ManiacalLabs/GalvoDriver/README.md

# GalvoDriver
Galvanometer Controller, DAC and Audio In
