ManiacalLabs/GalvoDriver/PCB/GalvoDriver.kicad_pcb

## KiCad design PCB/GalvoDriver.kicad_pcb (2020-10-03)

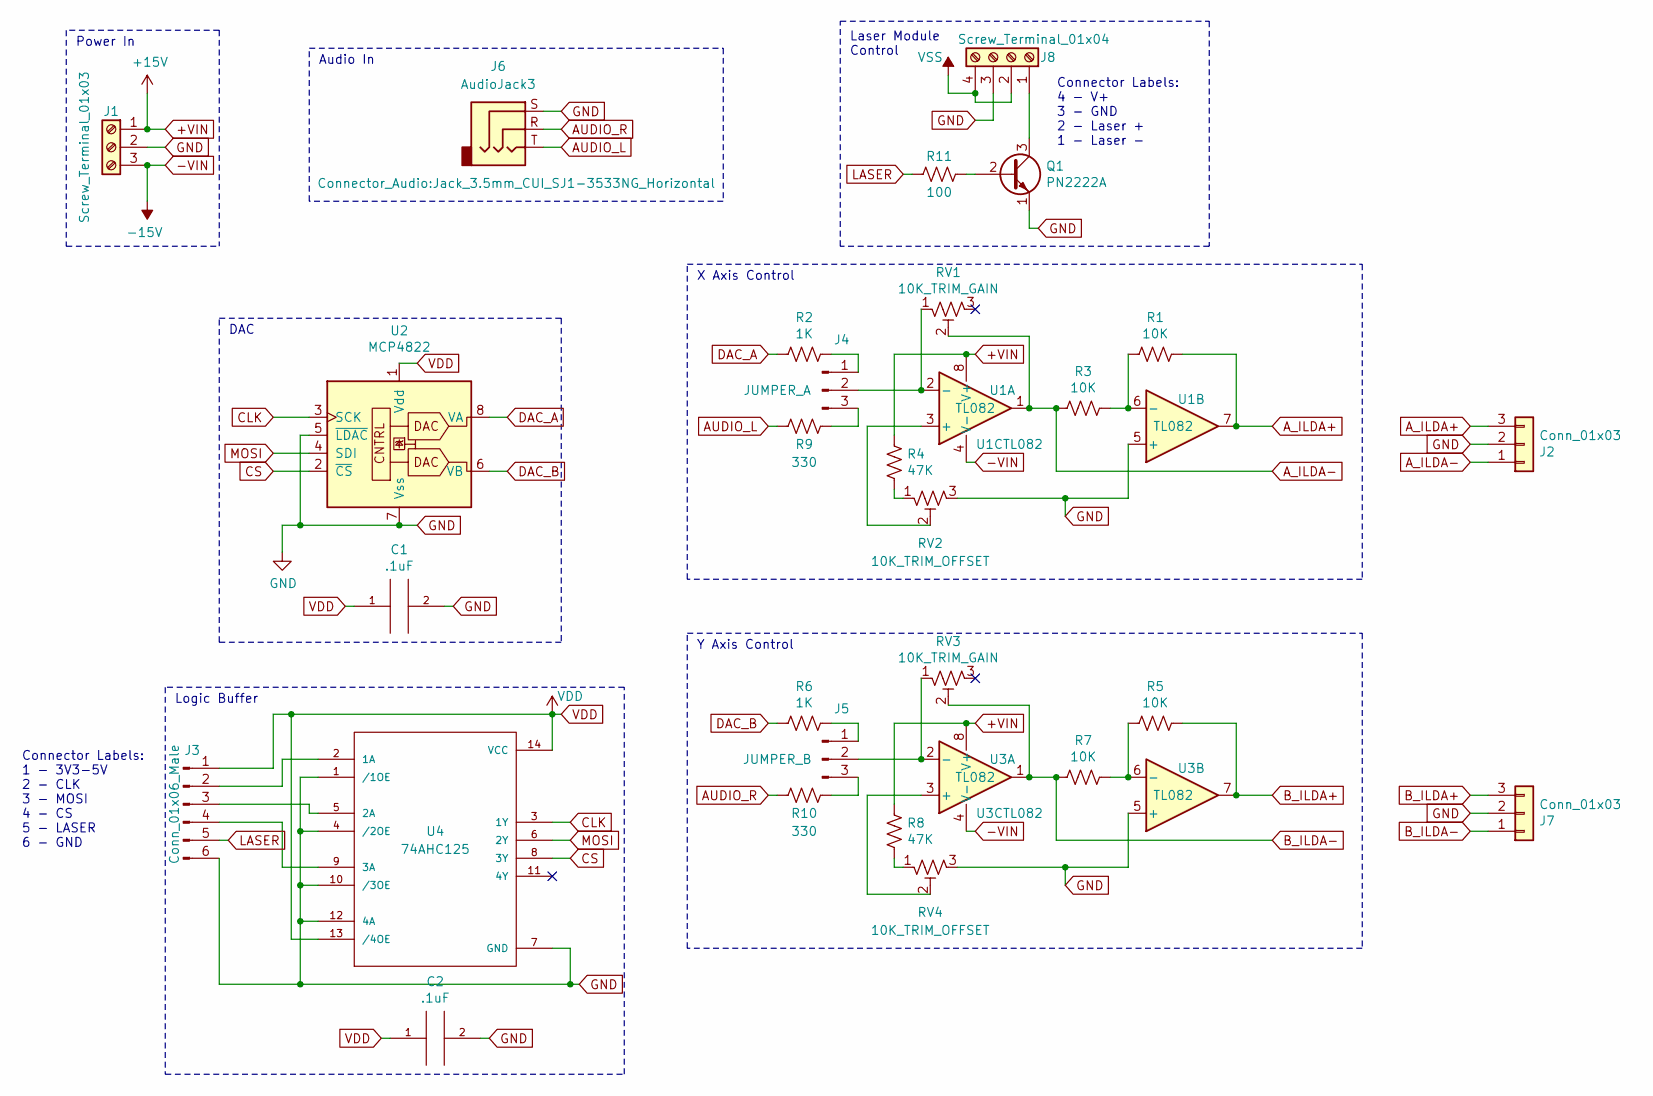
[picture p1: schematic GalvoDriver.sch]

Parts:
C1, C2: .1uF; C_Disc_D5.0mm_W2.5mm_P2.50mm
J1: Screw_Terminal_01x03; TerminalBlock_Phoenix_MKDS1.5-3pol
J2, J7: Conn_01x03; JST_XH_B03B-XH-A_03x2.50mm_Straight
J3: Conn_01x06_Male; Pin_Header_Straight_1x06_Pitch2.54mm
J4: JUMPER_A; Pin_Header_Straight_1x03_Pitch2.54mm
J5: JUMPER_B; Pin_Header_Straight_1x03_Pitch2.54mm
J6: AudioJack3; Jack_3.5mm_CUI_SJ1-3533NG_Horizontal
J8: Screw_Terminal_01x04; TerminalBlock_Phoenix_MKDS1.5-4pol
Q1: PN2222A; TO-92_Inline_Wide
R1, R3, R5, R7: 10K; R_Axial_DIN0207_L6.3mm_D2.5mm_P10.16mm_Horizontal
R2, R6: 1K; R_Axial_DIN0207_L6.3mm_D2.5mm_P10.16mm_Horizontal
R4, R8: 47K; R_Axial_DIN0207_L6.3mm_D2.5mm_P10.16mm_Horizontal
R9, R10: 330; R_Axial_DIN0207_L6.3mm_D2.5mm_P10.16mm_Horizontal
R11: 100; R_Axial_DIN0207_L6.3mm_D2.5mm_P10.16mm_Horizontal
RV1, RV3: 10K_TRIM_GAIN; Potentiometer_Trimmer_Bourns_3296W
RV2, RV4: 10K_TRIM_OFFSET; Potentiometer_Trimmer_Bourns_3296W
U1, U3: TL082; DIP-8_W7.62mm_Socket
U2: MCP4822; DIP-8_W7.62mm_Socket
U4: 74AHC125; DIP-14_W7.62mm_Socket

Connections:
+VIN: J1.1, R4.2, R8.2, U1.8 (V+), U3.8 (V+)
-VIN: J1.3, U1.4 (V-), U3.4 (V-)
AUDIO_L: J6.T, R9.2
AUDIO_R: J6.R, R10.2
A_ILDA+: J2.3, R1.1, U1.7
A_ILDA-: J2.1, R3.2, RV1.2, U1.1
B_ILDA+: J7.3, R5.1, U3.7
B_ILDA-: J7.1, R7.2, RV3.2, U3.1
CLK: U2.3 (SCK), U4.3 (1Y)
CS: U2.2 (~CS), U4.8 (3Y)
DAC_A: R2.2, U2.8 (VA)
DAC_B: R6.2, U2.6 (VB)
GND: C1.2, C2.2, J1.2, J2.2, J3.6, J6.S, J7.2, J8.3, Q1.1 (E), RV2.3, RV4.3, U1.5 (+), U2.5 (~LDAC), U2.7 (Vss), U3.5 (+), U4.1 (/1OE), U4.4 (/2OE), U4.7 (GND), U4.10 (/3OE), U4.12 (4A)
LASER: J3.5, R11.2
MOSI: U2.4 (SDI), U4.6 (2Y)
unnamed: J3.2, U4.2 (1A)
unnamed: J3.3, U4.5 (2A)
unnamed: J3.4, U4.9 (3A)
unnamed: J4.1, R2.1
unnamed: J4.2, RV1.1, U1.2 (-)
unnamed: J4.3, R9.1
unnamed: J5.1, R6.1
unnamed: J5.2, RV3.1, U3.2 (-)
unnamed: J5.3, R10.1
unnamed: J8.1, Q1.3 (C)
unnamed: Q1.2 (B), R11.1
unnamed: R1.2, R3.1, U1.6 (-)
unnamed: R4.1, RV2.1
unnamed: R5.2, R7.1, U3.6 (-)
unnamed: R8.1, RV4.1
unnamed: RV2.2, U1.3 (+)
unnamed: RV4.2, U3.3 (+)
VDD: C1.1, C2.1, J3.1, U2.1 (Vdd), U4.13 (/4OE), U4.14 (VCC)
VSS: J8.2, J8.4

Notes on the sheet:
Connector Labels: 1 - 3V3-5V 2 - CLK 3 - MOSI 4 - CS 5 - LASER 6 - GND
Y Axis Control
X Axis Control
Connector Labels: 4 - V+ 3 - GND 2 - Laser + 1 - Laser -
Laser Module Control
Power In
DAC
Audio In
Logic Buffer

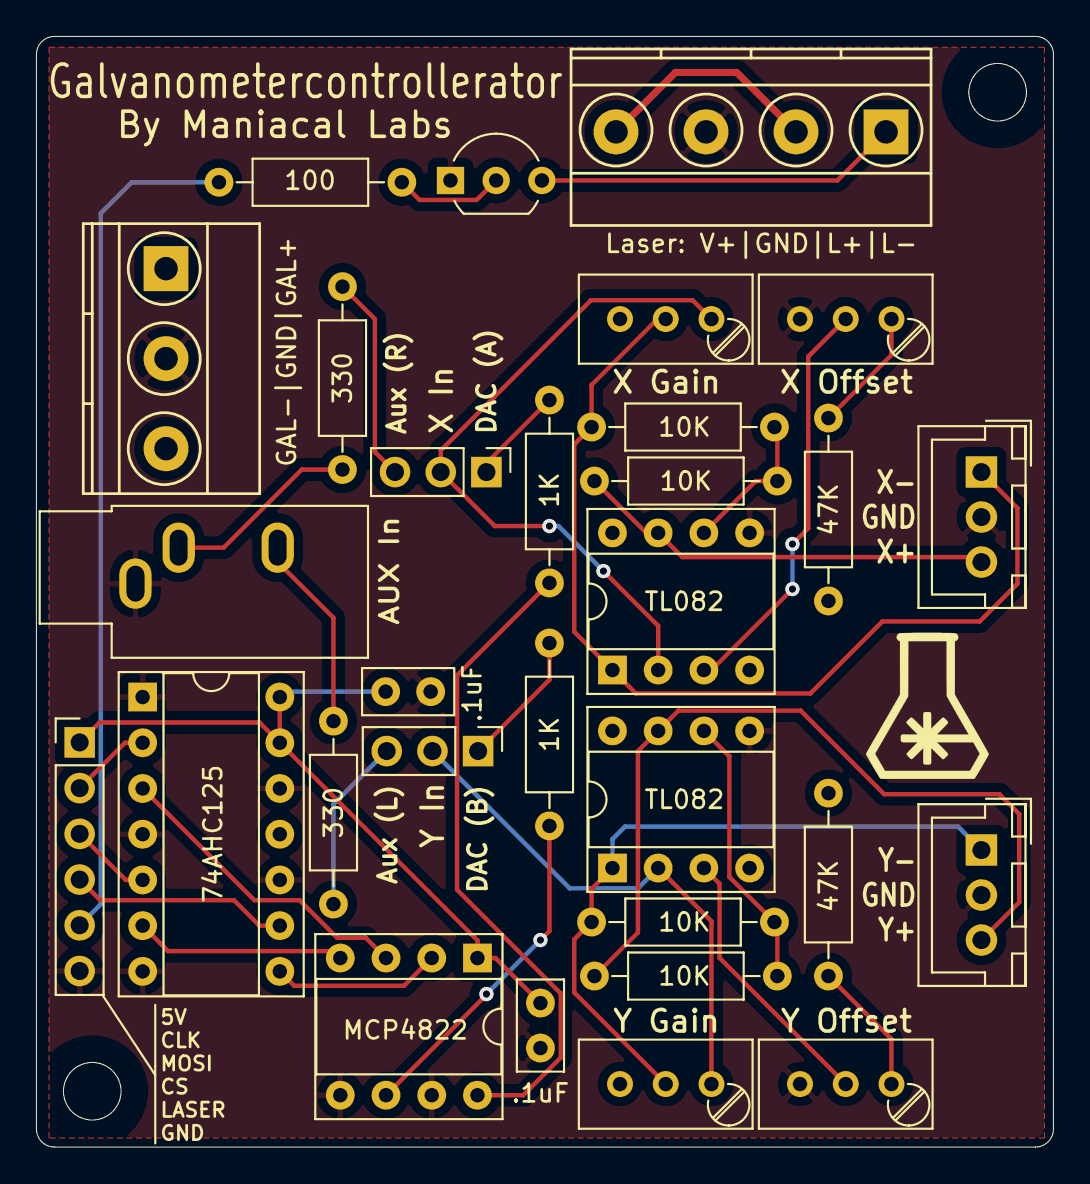
[picture p2: board GalvoDriver.kicad_pcb from above]

Board: 4 copper layers, 56.5 x 61.7 mm, 30 parts (0 on the bottom side), 34 nets.
