ManiacalLabs/GalvoDriver/LaserDemo/p_test.h

const uint32_t PROGMEM draw_test[] = {
0x879b03e5,
0x8795042c,
0x8795042c,
0x87840471,
0x87840471,
0x876804b1,
0x876804b1,
0x874304eb,
0x874304eb,
0x8716051d,
0x8716051d,
0x86e30545,
0x86e30545,
0x86ad0562,
0x86ad0562,
0x86740575,
0x86740575,
0x863c057d,
0x863c057d,
0x8607057a,
0x8607057a,
0x85d7056d,
0x85d7056d,
0x85ad0559,
0x85ad0559,
0x858c053d,
0x858c053d,
0x8574051d,
0x8574051d,
0x856704fa,
0x856704fa,
0x856404d7,
0x856404d7,
0x856b04b6,
0x856b04b6,
0x857b0499,
0x857b0499,
0x85940483,
0x85940483,
0x85b40474,
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
};

void test() {
  objectCount++;  
  objectAddress[objectCount] = draw_test;
  objectName[objectCount] = "test";
  objectSize[objectCount] = sizeof(draw_test)/sizeof(uint32_t);
}
