ManiacalLabs/GalvoDriver/(commit log)

2020-06-28 KiCAD Project commit
    [GalvoDriver.kicad_pcb, GalvoDriver.sch]
2020-06-28 Moved to PCB dir
    [GalvoDriver.kicad_pcb, GalvoDriver.sch]
2020-07-07 Added Laser Module Control + terminal
    [GalvoDriver.kicad_pcb, GalvoDriver.sch]
2020-07-07 Added terminal labels, exported gerbers for fab.
    [GalvoDriver-B_Cu.gbr, GalvoDriver-B_Mask.gbr, GalvoDriver-Edge_Cuts.gbr, GalvoDriver-F_Cu.gbr, GalvoDriver-F_Mask.gbr, GalvoDriver-F_SilkS.gbr, GalvoDriver-In1_Cu.gbr, GalvoDriver-In2_Cu.gbr]
2020-07-14 Changed decoupling cap value to 0.1uF
    [GalvoDriver.kicad_pcb, GalvoDriver.sch]
2020-08-19 Starting work on PCB changes for v1.1
    [GalvoDriver.sch]
2020-08-19 Level shifter, thrm. relief, xistor pad, audio jack move
    [GalvoDriver.kicad_pcb, GalvoDriver.sch]
2020-08-19 Fixing Aux In and C2 silk
    [GalvoDriver.kicad_pcb]
2020-09-03 Generated gerber files, uploaded v2 to board fab.
    [GalvoDriver-B_Cu.gbr, GalvoDriver-B_Mask.gbr, GalvoDriver-Edge_Cuts.gbr, GalvoDriver-F_Cu.gbr, GalvoDriver-F_Mask.gbr, GalvoDriver-F_SilkS.gbr, GalvoDriver-In1_Cu.gbr, GalvoDriver-In2_Cu.gbr]
2020-10-02 Added CS connection to header, buffer, DAC input
    [GalvoDriver.kicad_pcb, GalvoDriver.sch]
2020-10-03 Flipped ILDA connector wiring and silkscreen labels
    [GalvoDriver.kicad_pcb, GalvoDriver.sch]
