ManiacalLabs/GalvoDriver/(notices)

Notices in the files:
LaserDemo/TimerThree.h:
This is free software. You can redistribute it and/or modify it under
the terms of Creative Commons Attribution 3.0 United States License.
To view a copy of this license, visit http://creativecommons.org/licenses/by/3.0/us
or send a letter to Creative Commons, 171 Second Street, Suite 300, San Francisco, California, 94105, USA.
